noralschimpf/Capstone-ChickenCoopDoor/README.md

# Capstone-ChickenCoopDoor
Software and Documentation Repo for the Team 2 Capstone
