noralschimpf/Capstone-ChickenCoopDoor/Solidworks/Gainta G311MF Enclosure.SLDASM

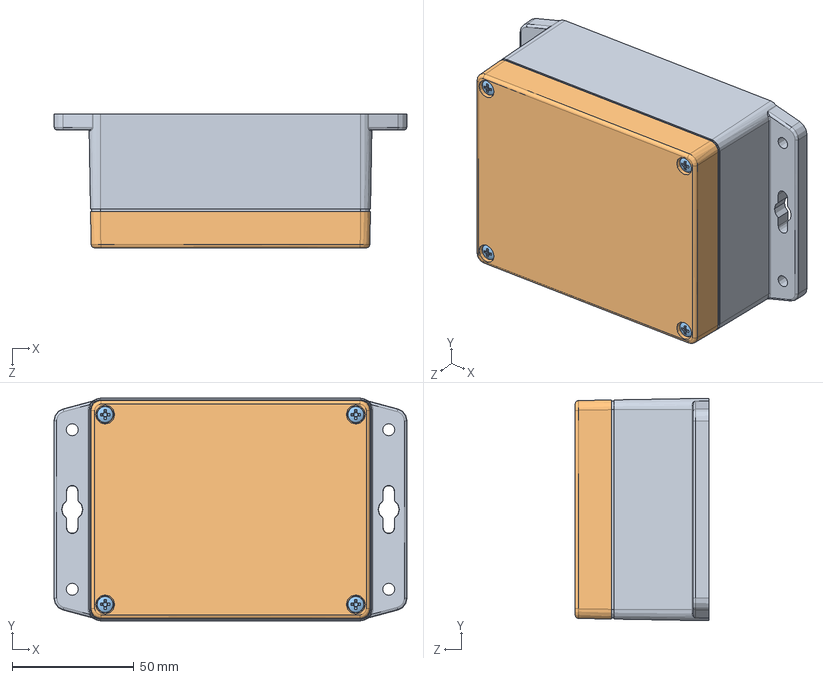
[picture p1: CAD file, 2020-01-19]
Solidworks/Gainta G311MF Enclosure.SLDASM
145.0 x 91.4 x 55.0 mm
Gainta G311MF - base
Gainta G311MF - cover
Pan head screw - M4x16 x 4
