noralschimpf/Capstone-ChickenCoopDoor/Solidworks/G258_G368.SLDPRT

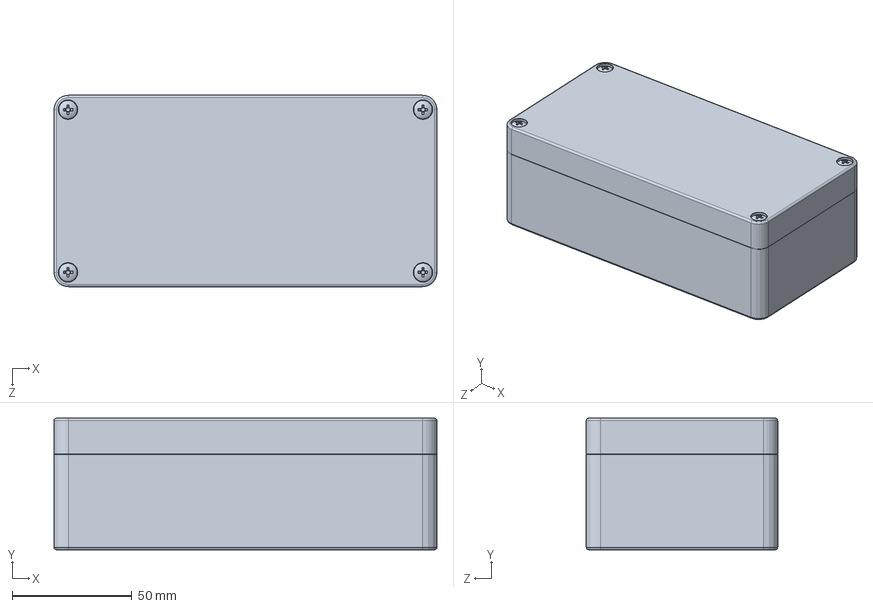
[picture p2: CAD file, 2020-01-19]
Solidworks/G258_G368.SLDPRT
160.0 x 55.0 x 80.0 mm
