noralschimpf/Capstone-ChickenCoopDoor/Schematics/Schematic PDF.pdf

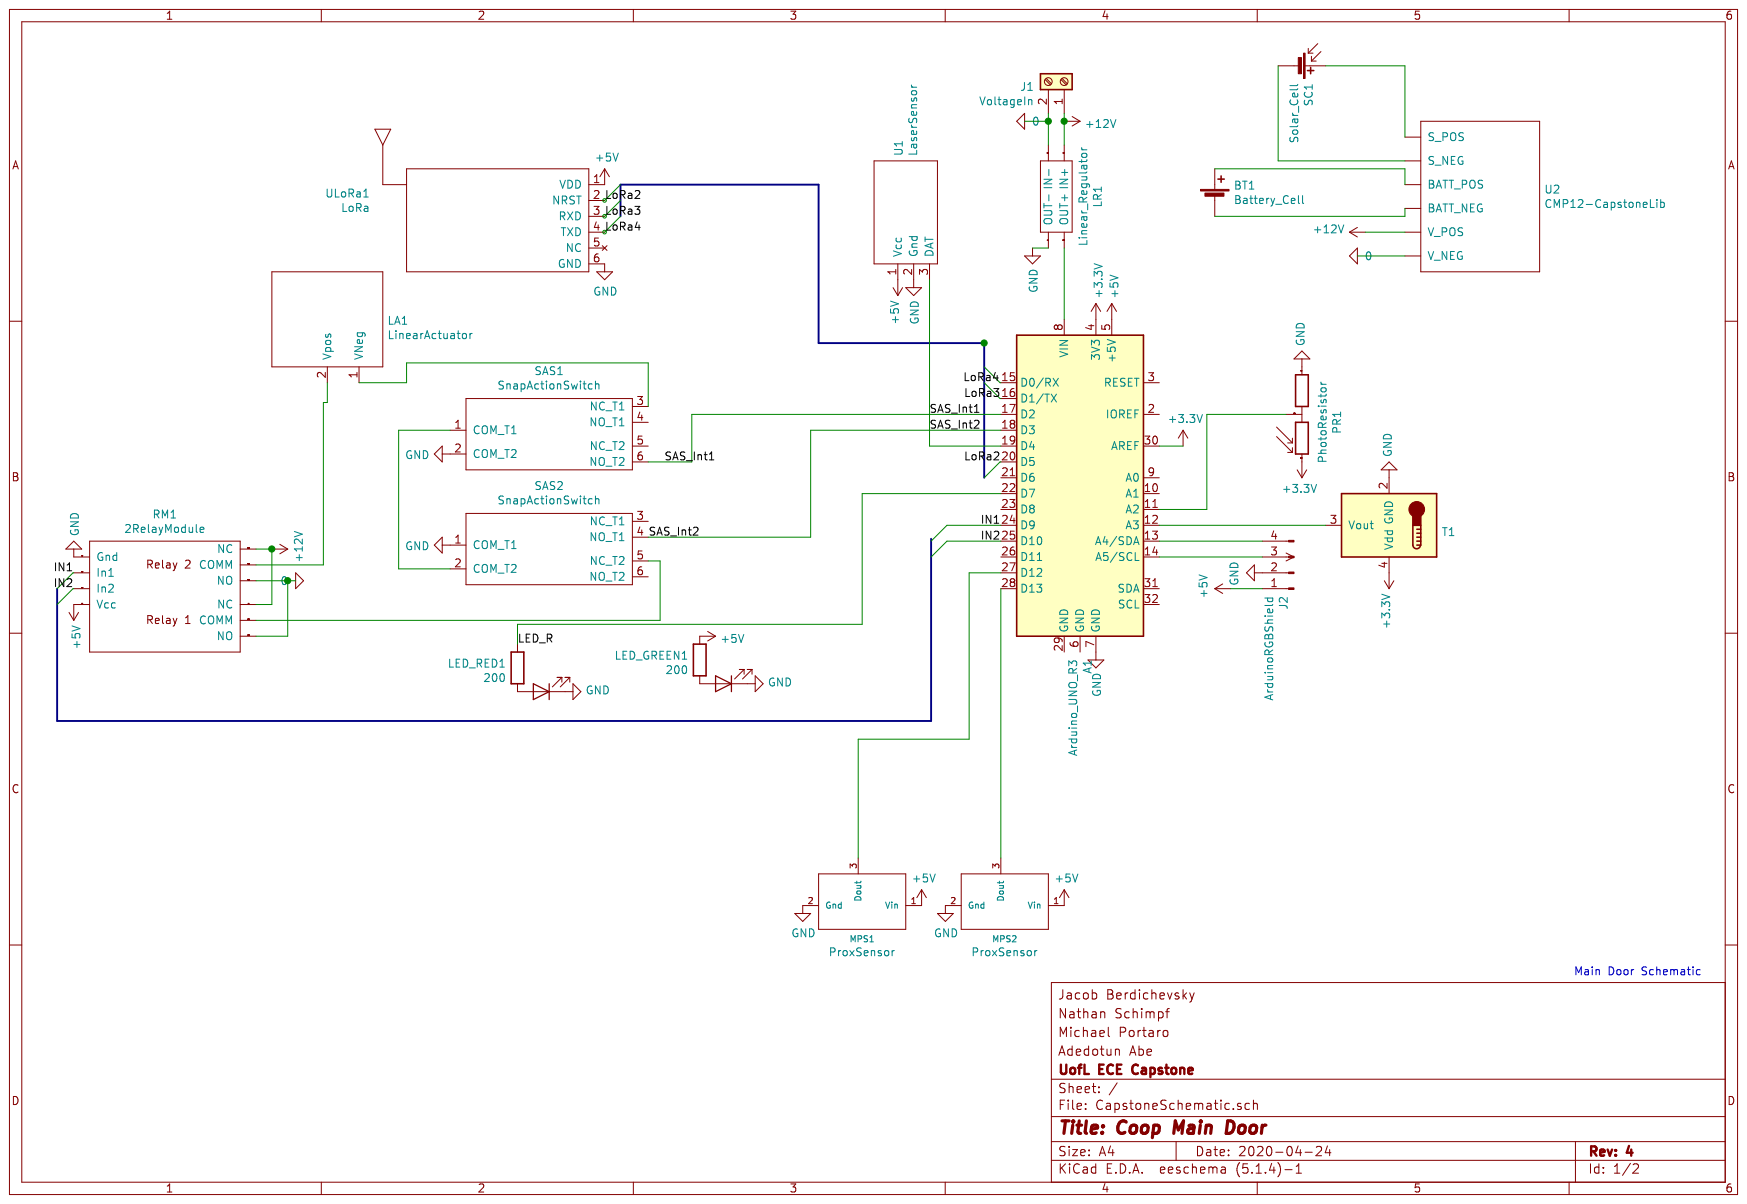
[picture p3: page 1]

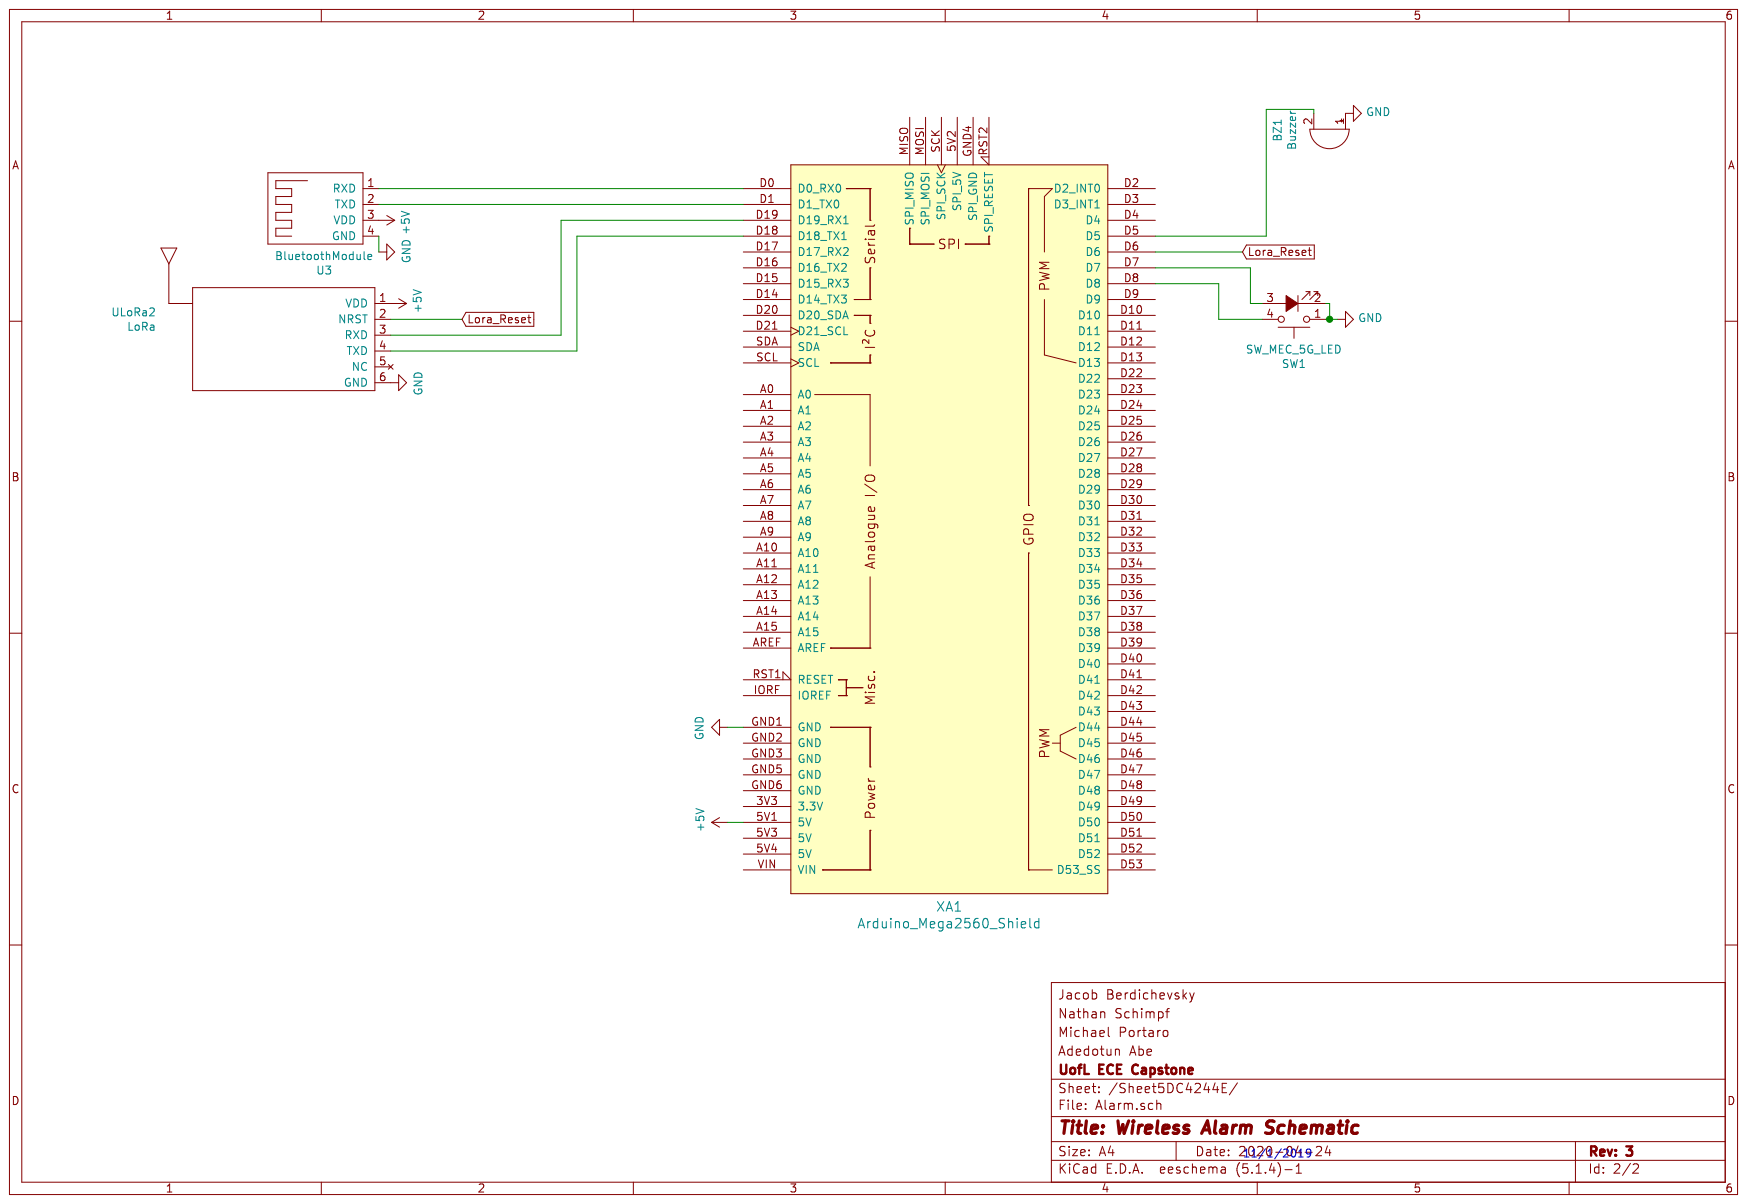
[picture p4: page 2]
