noralschimpf/Capstone-ChickenCoopDoor/Schematics/Alarm.kicad_pcb

## KiCad design Schematics/Alarm.kicad_pcb (2020-04-20)

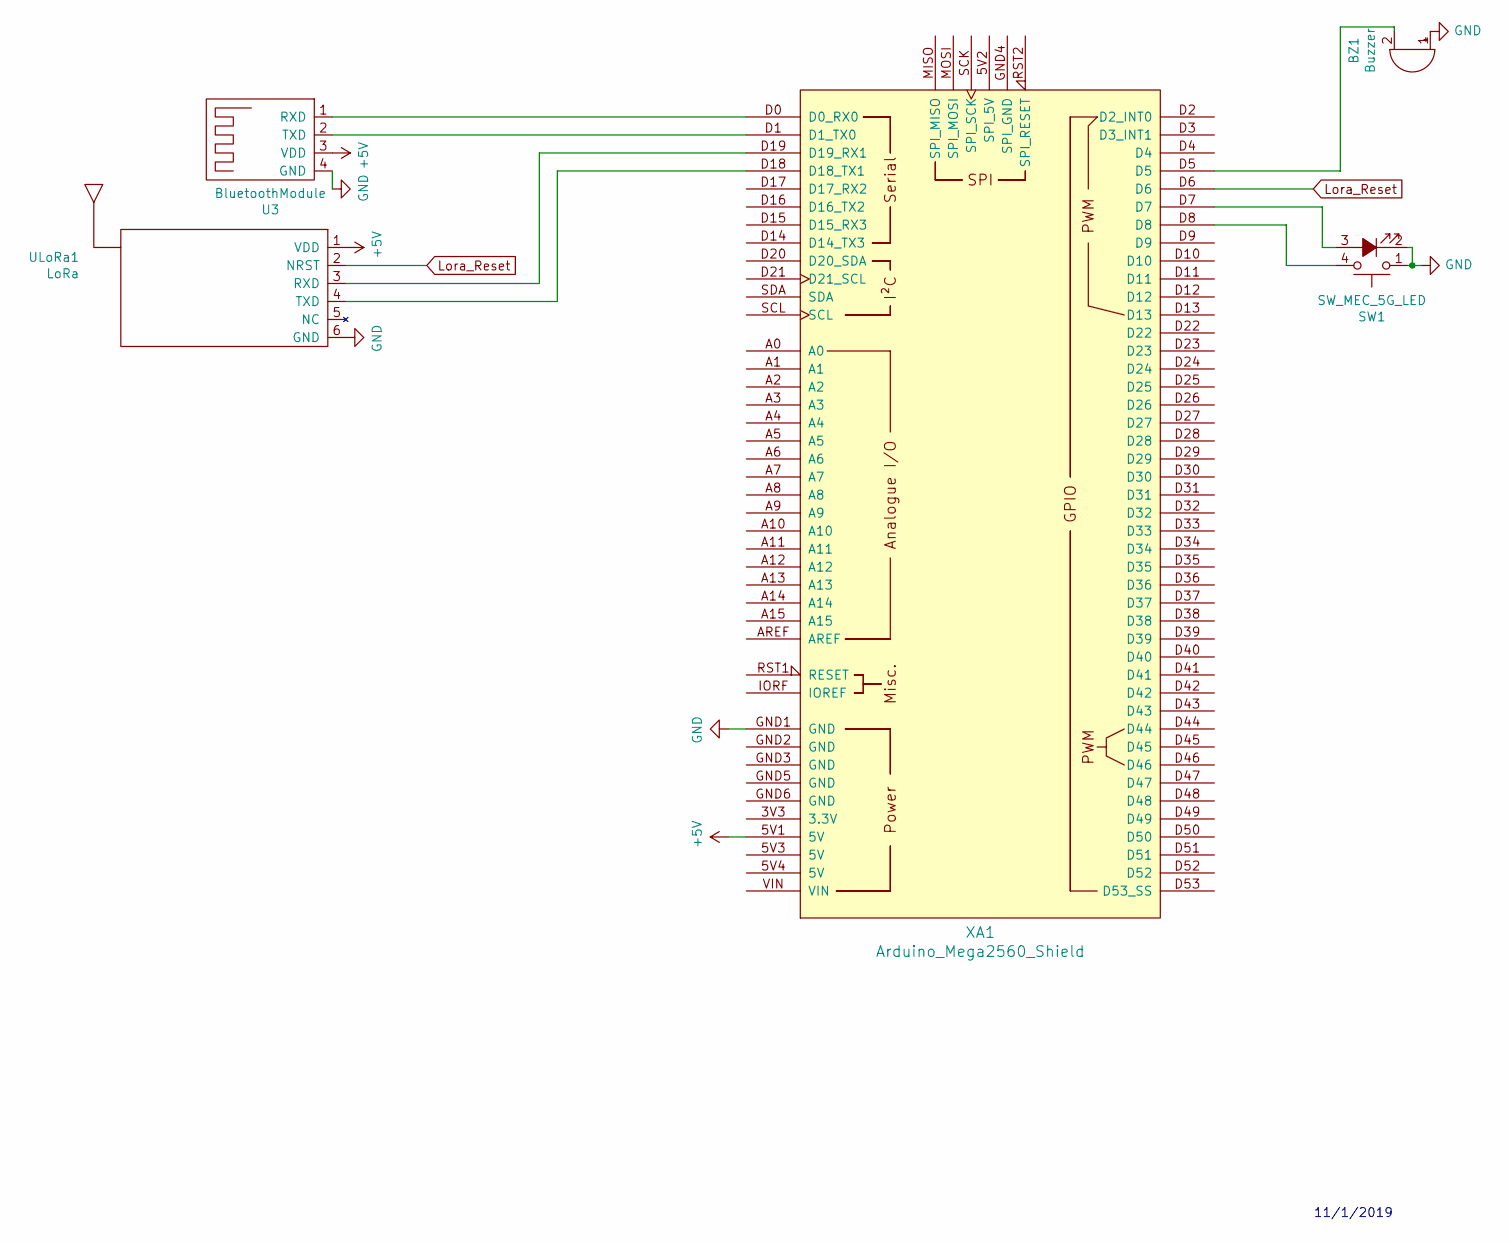
[picture p5: schematic Alarm.sch, Wireless Alarm Schematic]

Parts:
BZ1: Buzzer; Buzzer_15x7.5RM7.6
SW1: SW_MEC_5G_LED; Button
U3: BluetoothModule; PinSocket_1x04_P2.54mm_Horizontal
ULoRa1: LoRa; PinSocket_1x06_P2.54mm_Horizontal
XA1: Arduino_Mega2560_Shield

Connections:
+5V: U3.3 (VDD), ULoRa1.1 (VDD), XA1.5V1 (5V)
GND: BZ1.1 (-), SW1.1, SW1.2, U3.4 (GND), ULoRa1.6 (GND), XA1.GND1 (GND)
Lora_Reset: ULoRa1.2 (NRST), XA1.D6
unnamed: BZ1.2 (+), XA1.D5
unnamed: SW1.3 (K), XA1.D7
unnamed: SW1.4 (A), XA1.D8
unnamed: U3.1 (RXD), XA1.D0 (D0_RX0)
unnamed: U3.2 (TXD), XA1.D1 (D1_TX0)
unnamed: ULoRa1.3 (RXD), XA1.D19 (D19_RX1)
unnamed: ULoRa1.4 (TXD), XA1.D18 (D18_TX1)

Notes on the sheet:
11/1/2019

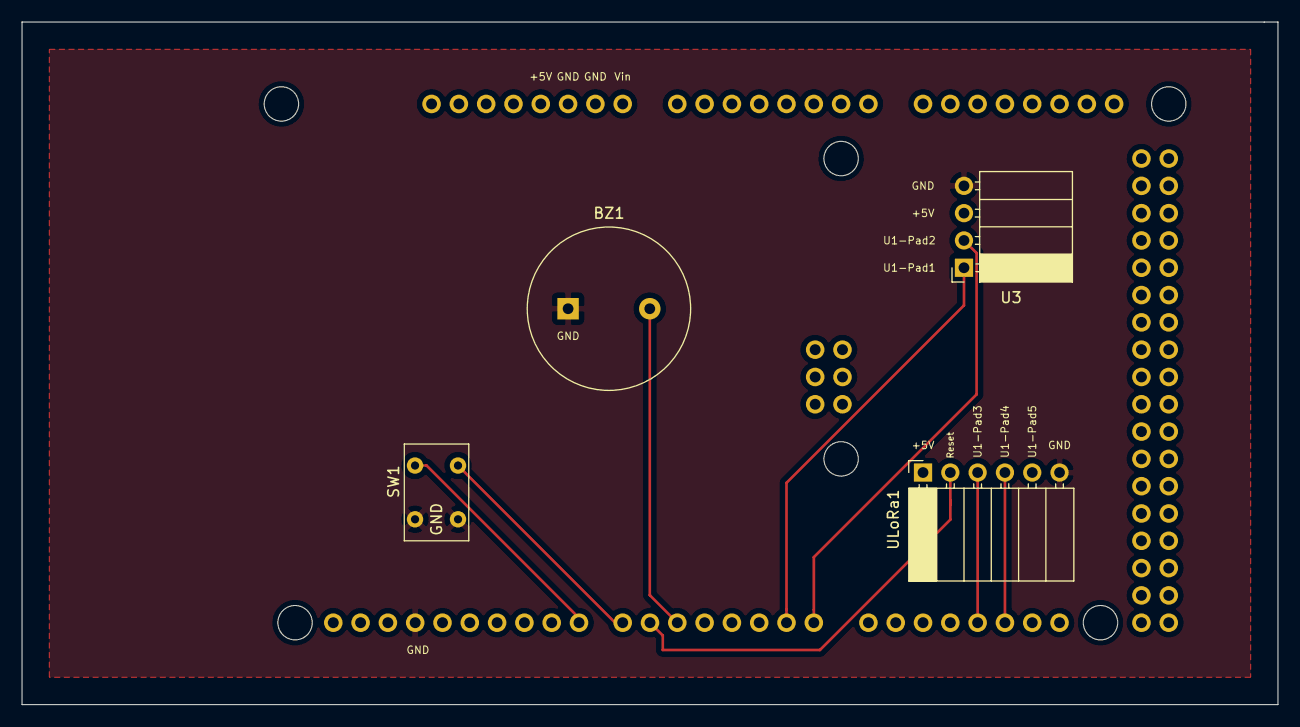
[picture p6: board Alarm.kicad_pcb from above]

Board: 2 copper layers, 116.8 x 63.5 mm, 5 parts (1 on the bottom side), 10 nets.
