noralschimpf/Capstone-ChickenCoopDoor/Schematics/CapstoneSchematic.kicad_pcb

## KiCad design Schematics/CapstoneSchematic.kicad_pcb (2020-04-15)

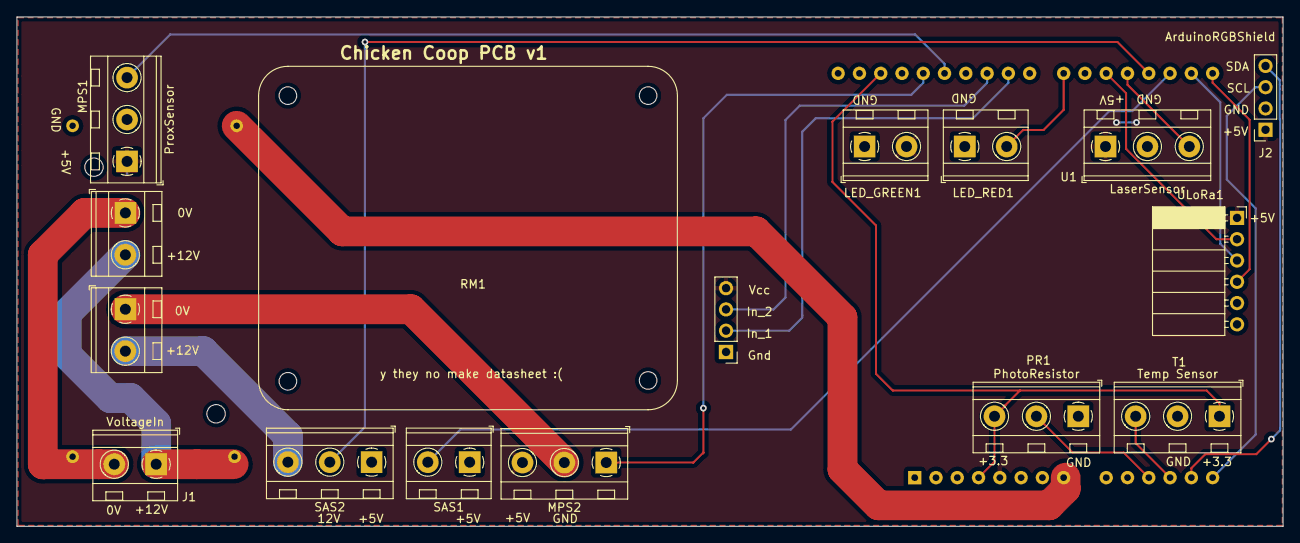
[picture p7: board CapstoneSchematic.kicad_pcb from above]

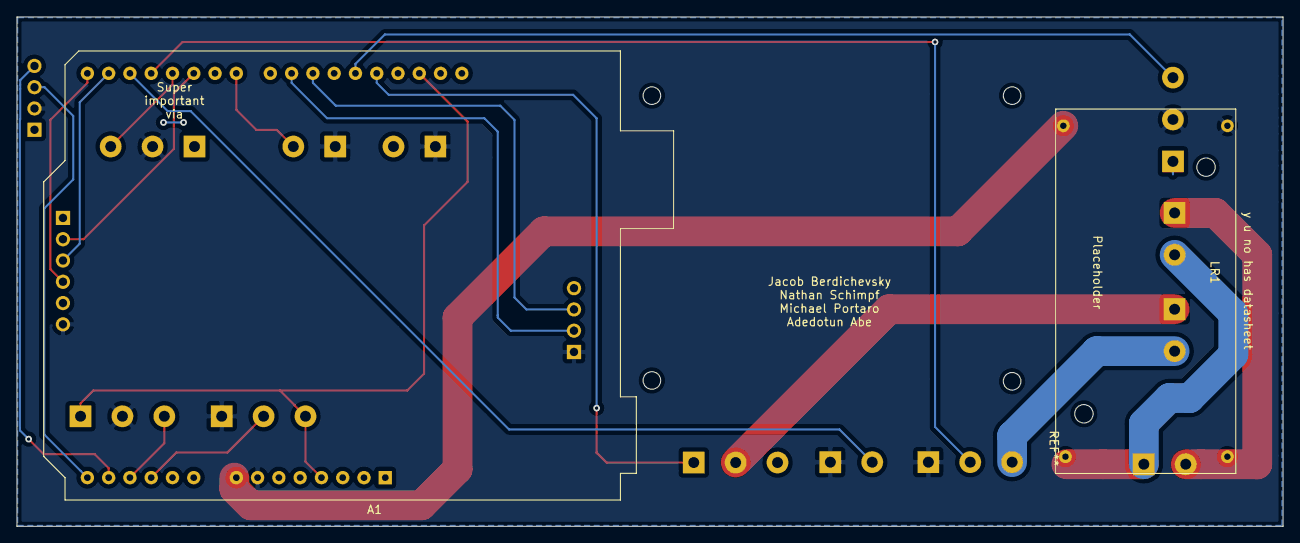
[picture p8: board CapstoneSchematic.kicad_pcb from below]

Board: 2 copper layers, 151.1 x 60.8 mm, 15 parts (2 on the bottom side), 21 nets.

Parts:
A1: Arduino_UNO_R3
J1: VoltageIn; TerminalBlock_MetzConnect_Type094_RT03502HBLU_1x02_P5.00mm_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
J2: ArduinoRGBShield; PinSocket_1x04_P2.54mm_Vertical
LED_GREEN1: 200; TerminalBlock_MetzConnect_Type094_RT03502HBLU_1x02_P5.00mm_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
LED_RED1: 200; TerminalBlock_MetzConnect_Type094_RT03502HBLU_1x02_P5.00mm_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
LR1: Linear_Regulator; Linear Regulator
MPS1, MPS2: ProxSensor; TerminalBlock_MetzConnect_Type094_RT03503HBLU_1x03_P5.00mm_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
PR1: PhotoResistor; TerminalBlock_MetzConnect_Type094_RT03503HBLU_1x03_P5.00mm_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
RM1: 2RelayModule; 2 Channels Relay
SAS1: SnapActionSwitch; TerminalBlock_MetzConnect_Type094_RT03502HBLU_1x02_P5.00mm_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
SAS2: SnapActionSwitch; TerminalBlock_MetzConnect_Type094_RT03503HBLU_1x03_P5.00mm_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
T1: Temp Sensor; TerminalBlock_MetzConnect_Type094_RT03503HBLU_1x03_P5.00mm_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
U1: LaserSensor; TerminalBlock_MetzConnect_Type094_RT03503HBLU_1x03_P5.00mm_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
ULoRa1: LoRa; PinSocket_1x06_P2.54mm_Horizontal

Connections:
0: J1.2, LR1.2, RM1.8
+3V3: A1.4, A1.30, PR1.3, T1.4
+5V: A1.5, J2.1, LED_GREEN1.2, MPS1.1, MPS2.1, RM1.4, U1.1, ULoRa1.1
+12V: J1.1, LR1.1, RM1.10
/IN1: A1.24, RM1.2
/IN2: A1.25, RM1.3
/LED_R: A1.22, LED_RED1.2
/LoRa2: A1.20, ULoRa1.2
/SAS_Int1: A1.17, SAS1.4
/SAS_Int2: A1.18, SAS2.2
GND: A1.7, J2.2, LED_GREEN1.1, LED_RED1.1, LR1.4, MPS1.2, PR1.1, RM1.1, SAS1.1, SAS2.1, T1.2, U1.2, ULoRa1.6
unnamed: A1.8, LR1.3
unnamed: A1.11, PR1.2
unnamed: A1.12, T1.3
unnamed: A1.13, J2.4
unnamed: A1.14, J2.3
unnamed: A1.19, U1.3
unnamed: A1.27, MPS1.3
unnamed: A1.28, MPS2.3
unnamed: RM1.9, SAS2.4
unnamed: MPS2.2, RM1.6
