noralschimpf/Capstone-ChickenCoopDoor/Main Door/mainmenu/mainmenu.ino

#include "Arduino.h"
// #include "./Menu.cpp"

// Menu _menu;
// Door _door;
bool displayed;

void setup()
{                
  displayed= false;
  Serial.begin(9600);
//   _menu.Initialize(_door);
//   _menu.NavigateMainMenu();
}   

void loop()                     
{
}
