noralschimpf/Capstone-ChickenCoopDoor/(commit log)

2019-11-05 adding nathan and abe's changes
    [Alarm.sch]
2019-11-06 Added Door Obstruction sensor
    [Alarm.sch, CapstoneSchematic.sch]
2019-11-06 Initial Flowcharts
2019-11-09 Did main pcb
    [CapstoneSchematic.sch]
2019-11-09 Fixed the project
    [Alarm.sch, CapstoneSchematic.sch]
2019-11-10 finished pcb
    [Alarm.sch, CapstoneSchematic.kicad_pcb, CapstoneSchematic.sch]
2019-11-10 Fixed a layer
    [Alarm.sch, CapstoneSchematic.kicad_pcb, CapstoneSchematic.sch]
2019-11-14 Emergency fix
    [CapstoneSchematic-B_Cu.gbr, CapstoneSchematic-B_Mask.gbr, CapstoneSchematic-B_SilkS.gbr, CapstoneSchematic-Edge_Cuts.gbr, CapstoneSchematic-F_Cu.gbr, CapstoneSchematic-F_Mask.gbr, CapstoneSchematic-F_SilkS.gbr, CapstoneSchematic-NPTH.drl]
2019-11-16 Added flowchart and latest gerbers
2019-12-01 Menu and ADCs
    MISSING:
    ADC Decision Making,
    Scrolling Support
    Safety inputs
    [constant_parameters.h, demo_analog.ino]
2019-12-01 Menu Scrolling and ADC operation
    Day/Night Mode transition to door operation on ADC
    Menu refreshes line in 16-char increments
    auto-exit door operation states
    refresh displayed ADC values more frequently
    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
    [demo_analog.ino]
2019-12-02 Jacob and Nathan working on the project
    [CapstoneSchematic.sch]
2019-12-02 UPTO: ADC Readout precision fits LCD
2019-12-03 Schematic: updated Titleblock and notes
    [CapstoneSchematic.sch]
2020-01-19 Trying to fix door
    [demo_analog.ino]
2020-01-19 Enclosure Model
    [G258_G368.SLDPRT]
2020-01-19 Enclosure model (Wall Attachment)
    [Gainta G311MF Enclosure.SLDASM]
2020-01-19 Added note to schem
    [CapstoneSchematic.sch]
2020-02-23 Fixed repo
    [Alarm.sch, CapstoneSchematic.kicad_pcb, CapstoneSchematic.sch]
2020-02-23 Made things look better on wireless alarm
    [Alarm.sch]
2020-02-24 UPTO: Functioning Display - TODO: SPI Interrupts
2020-03-01 Add files via upload
    First draft of alarm PCB
    [Alarm.kicad_pcb]
2020-03-02 Fixed file organization
    [Alarm.kicad_pcb]
2020-03-11 Add files via upload
    Alarm PCB Rev 2
    [Alarm.kicad_pcb]
2020-03-18 Fixing folder
    [Alarm.kicad_pcb]
2020-03-23 Sensor drafting, Safety mod, Readme update
2020-03-23 Sensor Class Drafting
2020-04-05 Added Michael's alarm pcb rev
    [Alarm.kicad_pcb, Alarm.sch, CapstoneSchematic.sch]
2020-04-05 Changed the leds
    [Alarm.sch, CapstoneSchematic.sch]
2020-04-09 Alarm PCB Changes
    Fixes to the text layering and traces
2020-04-12 Fixed button
    [Alarm.sch]
2020-04-13 Fixed most of schematic, need to update linear regulator footprint
    [Alarm.kicad_pcb, Alarm.sch, CapstoneSchematic.kicad_pcb, CapstoneSchematic.sch]
2020-04-15 Fixed Linear regulator footprint
    [CapstoneSchematic.kicad_pcb]
2020-04-19 Added Code for door without interrupts
    [Alarm.sch]
2020-04-19 Added temp button pcb footprint
    [Alarm.kicad_pcb, Alarm.sch]
2020-04-19 Surface Changes And Button Retracking
    [Alarm.kicad_pcb]
2020-04-25 added comments and renamed folder
    [Alarm.sch, CapstoneSchematic.sch]
